HoangVanNamPTIT/BTL-Nhung/(commit log)

2026-04-21 feat: add Sparkline component for visualizing telemetry data
    feat: export Sparkline component from dashboard index
    refactor: enhance ActivityFeed with icons and colors for activity types
    refactor: update useDevice hook to include fetchActivities and device control functions
    style: update global styles for improved aesthetics and responsiveness
    feat: implement real-time updates in DashboardPage with socket integration
    fix: improve error handling and user feedback in LoginPage
    feat: enhance authentication store with better error messages
    feat: add device claiming and activity logging functionality in device store
    feat: create socket utility for managing real-time connections
    chore: ad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
2026-04-21 feat: Implement many-to-many relationship between users and devices
    - Added `user_devices` table to manage user-device relationships.
    - Removed `owner_id` from `devices` table to support multiple users per device.
    - Updated Prisma schema to reflect new relationships.
    - Modified controllers to handle user-device access instead of ownership.
    - Created reset-db script to facilitate database resets.
    - Removed obsolete seed-fake-devices script.
    - Updated onboarding wizard to display existing rooms for verified devices.
    - Changed application name from "SmartHome" to "AirQuality" in Navbar and LoginPage.
2026-04-21 update arduino code
2026-04-21 feat: Add main Arduino code for WiFi, MQTT, and sensor control
2026-04-27 feat: complete OTA feature and alarm control
    - Finalize OTA update functionality
    - Update UI and backend logic
    - Complete alarm control via physical button
2026-04-27 move Arduino folder to main project area
2026-04-28 update Arduino code : optimize OTA func and mqttCallBack
